dustywill/IAC-Tester/(commit log)

2025-12-27 Updated after schoosing the ESP32-S3
2025-12-30 Updated README for the IAC VALVE as connector
